Trevor16gordon/Heartbeat-Sensor/README.md

# Heartbeat-Sensor
4th Year Microelectronics Project
By Mitchell Johnston and Trevor Gordon

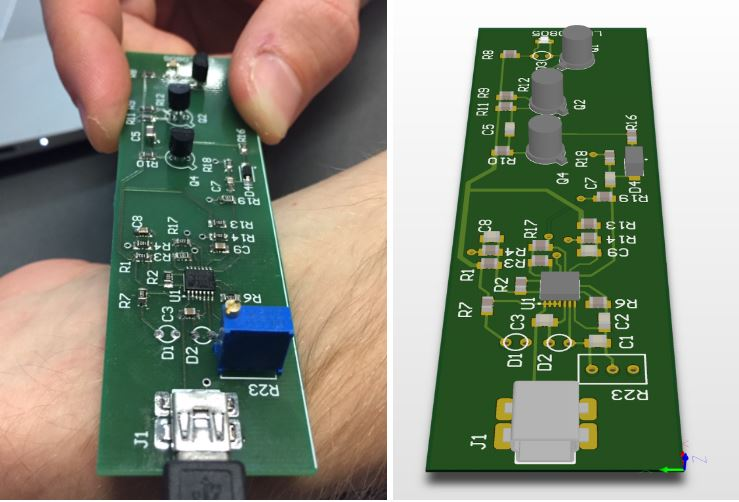
[picture p1: Images/SideBySide.JPG]

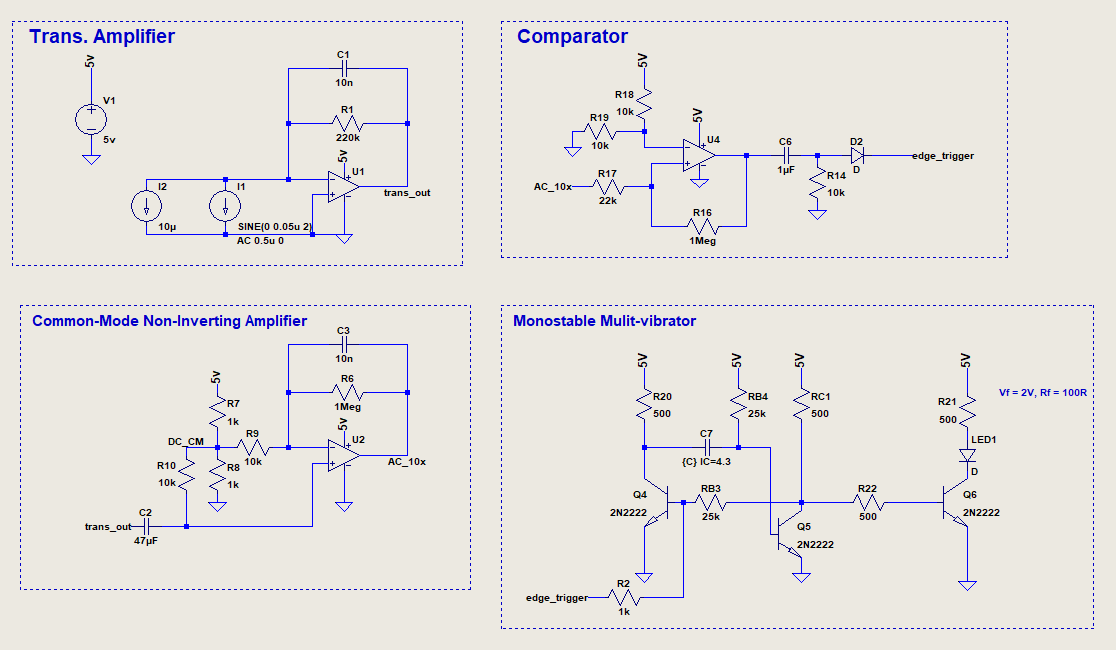
[picture p2: Images/SpiceSchematic.png]
