Trevor16gordon/Heartbeat-Sensor/Images/AltiumRender.png

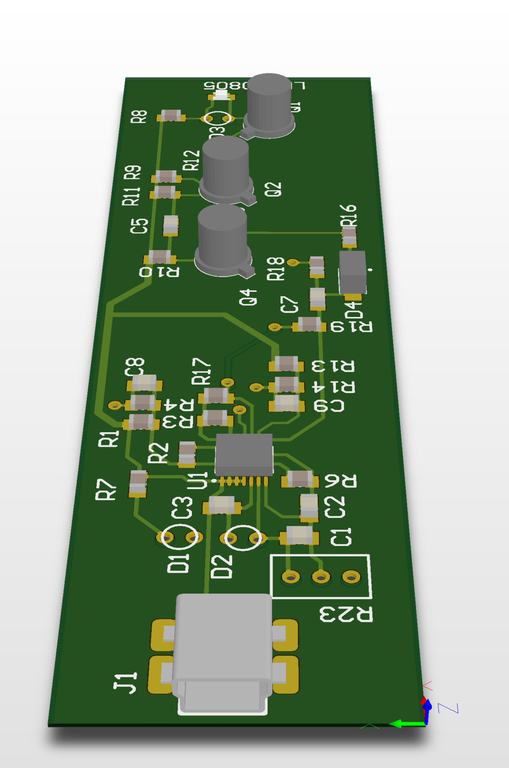
Images/AltiumRender.png
