Trevor16gordon/Heartbeat-Sensor/Images/CompletedBoard.jpg

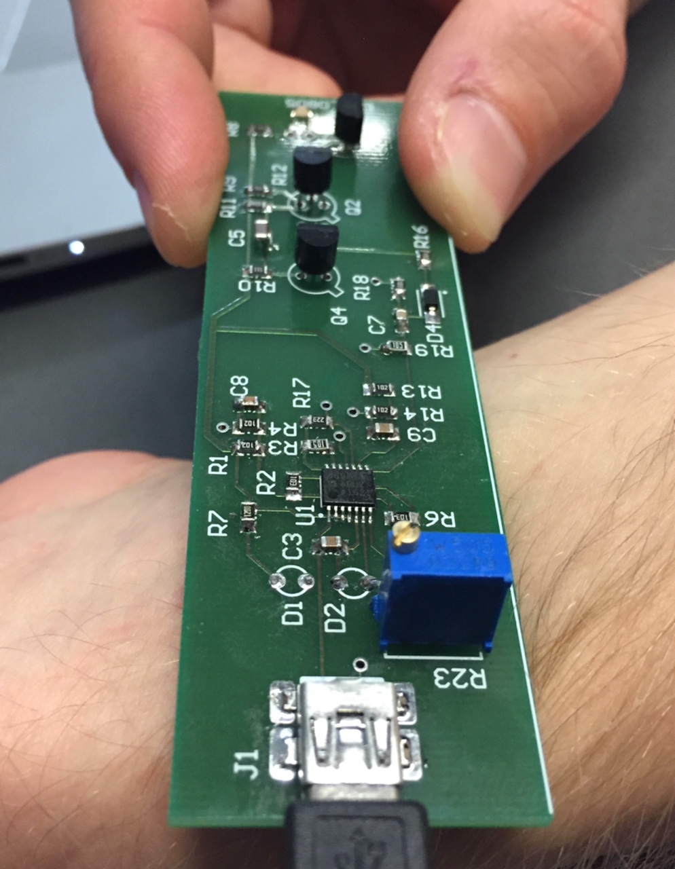
Images/CompletedBoard.jpg
