Trevor16gordon/Heartbeat-Sensor/LTSpice/multivibrator_cap_sweep.asc

C1: cap; 10n
C2: cap; 47µF
C3: cap; 10n
C4: cap; 1µF
C5: cap; {C} IC=4.3
D1: diode
I1: current; SINE(0 0.05u 2); AC 0.5u 0
I2: current; 10µ
LED: diode
Q1: npn; 2N2222
Q2: npn; 2N2222
Q3: npn; 2N2222
R1: res; 220k
R2: res; 10k
R3: res; 1Meg
R4: res; 22k
R5: res; 10k
R6: res; 1Meg
R7: res; 1k
R8: res; 1k
R9: res; 10k
R10: res; 10k
R11: res; 10k
R12: res; 500
R13: res; 500
R15: res; 500
RB1: res; 25k
RB2: res; 25k
RC2: res; 500
U1: UniversalOpamp2
U2: UniversalOpamp2
U3: UniversalOpamp2
V1: voltage; 5v
Named nets: 0, 5v, trans_out, DC_CM, AC_10x, edge_trigger, 5V
.include MCP601.txt
low frequencies: Vo = I*R1
;ac dec 20 0.1 100
.tran 800m
.model npn1 npn (Bf=100 ls=10f)
Vf = 2V, Rf = 100R
.param C = 11u
.step param C 5u 15u 2u
