Trevor16gordon/Heartbeat-Sensor/(list of files, drawings)

Other design files:
ENGR451_Project.PrjPcb
Sheet1.SchDoc
Sheet2.SchDoc
TwoLayer/HeartBeatTwoLayer/HeartbeatLibrary.PcbLib
TwoLayer/HeartBeatTwoLayer/HeartbeatLibrary.SchLib
TwoLayer/HeartBeatTwoLayer/heartbeatPCB.PcbDoc
TwoLayer/HeartBeatTwoLayer/HeartBeatTwoLayer.PrjPcb
TwoLayer/HeartBeatTwoLayer/Sheet1.SchDoc
TwoLayer/HeartBeatTwoLayer/Sheet2.SchDoc
