Trevor16gordon/Heartbeat-Sensor/(commit log)

2017-10-14 Finished schematic, first commit of board layout
    [ENGR451_Project.PrjPcb, HeartbeatLibrary.PcbLib, HeartbeatLibrary.SchLib, PCB1.PcbDoc, Sheet1.SchDoc, Sheet2.SchDoc]
2017-10-14 updated libraries and schematics to include pot
    [HeartbeatLibrary.PcbLib, HeartbeatLibrary.SchLib, Sheet1.SchDoc]
2017-10-14 updating pcb files and variants
    [HeartbeatLibrary.PcbLib, HeartbeatLibrary.SchLib, PCB1.PcbDoc, Sheet1.SchDoc]
2017-10-15 updating board
    [HeartbeatLibrary.PcbLib, HeartbeatLibrary.SchLib, PCB1.PcbDoc, Sheet1.SchDoc, Sheet2.SchDoc]
2017-10-15 fabrication outputs and small layout changes
    [PCB1.PcbDoc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]
2017-11-06 Started two layer board for fabrication. Rough Layout
    [HeartBeatTwoLayer.PrjPcb, HeartbeatLibrary.PcbLib, HeartbeatLibrary.SchLib, Sheet1.SchDoc, Sheet2.SchDoc, heartbeatPCB.PcbDoc]
2017-11-06 Cleaned PCB to be neater
    [heartbeatPCB.PcbDoc]
2017-11-14 Finished Two Layer
    [HeartBeatTwoLayer.PrjPcb, Sheet1.SchDoc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]
2017-11-15 Changed to standard hole sizes
    [HeartbeatLibrary.SchLib, Sheet1.SchDoc, Sheet2.SchDoc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]
2017-11-15 final fabrication files & design rule checks
    [PCB1.PcbDoc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]
2017-11-28 final fab. files & board fixes
    [heartbeatPCB.GBL, heartbeatPCB.GBO, heartbeatPCB.GBP, heartbeatPCB.GBS, heartbeatPCB.GM1, heartbeatPCB.GTL, heartbeatPCB.GTO, heartbeatPCB.GTP]
